whatnick/rpi-camera-led/firmware/README.md

# CH32V003A4M6 camera-LED controller firmware

Firmware for the CH32V003A4M6 (RISC-V, SOP-16) sitting on the Raspberry
Pi camera interposer board in this repository. It:

1. drives or tri-states the two camera-side GPIO pins,
2. reads back the two Pi-side GPIO pins (via the tri-stated passthrough),
3. can put either channel into "copy mode" (the Pi's GPIO passes
   straight through to the camera),
4. continuously samples and averages an ambient-light phototransistor,
5. drives two white illumination LEDs via hardware PWM, and
6. supports a fail-safe firmware upgrade over I2C.

Everything is controlled by a Raspberry Pi over I2C, using a plain
"8-bit register pointer, auto-incrementing" protocol compatible with
`i2c-tools` (`i2cget`/`i2cset`/`i2ctransfer`) and kernel `regmap-i2c`
drivers out of the box.

**Build status: both firmware images build successfully with the
open-source toolchain described below. Hardware status: UNTESTED.
Nobody has flashed this onto a real board or scoped a single pin -- see
"Known risks" and "What is untested" at the end of this document.**

## Hardware

(CH32V003A4M6, SOIC/SOP-16; pin numbers follow the SOP-16 column in the
WCH CH32V003 datasheet.) Unlike the smaller package, these package pins
do not bond multiple GPIO ports together:

| Package pin | Port / function | Net | Notes |
|---|---|-----|---|
| 1 | PC1 / I2C1 SDA | SDA | I2C slave on the shared Pi camera bus. |
| 2 | PC2 / I2C1 SCL | SCL | |
| 3 | PC3 / TIM1 CH3 | LED_PWM | Drives the LED MOSFET gate through its series resistor. |
| 4 | PC4 / ADC A2 | LIGHT_SENSE | Phototransistor input; more light raises the sensed voltage. |
| 5 | PC6 | NC | Unused. |
| 6 | PC7 | NC | Unused. |
| 7 | PD1 / SWIO | SWIO | Programming/debug interface; not used for LED PWM. |
| 8 | PD4 | NC | Unused. |
| 9 | PD5 | PI_IO0 | Samples the Pi-side GPIO0 signal. |
| 10 | PD6 | PI_IO1 | Samples the Pi-side GPIO1 signal. |
| 11 | PD7 / NRST | NC | Left unconnected; may act as reset depending on option bytes. |
| 12 | PA1 | CAM_IO0 | Drives or tri-states camera GPIO 11; R6 (10k) links to PI_IO0. |
| 13 | PA2 | CAM_IO1 | Drives or tri-states camera GPIO 12; R7 (10k) links to PI_IO1. |
| 14 | VSS | GND | |
| 15 | VDD | 3V3 | |
| 16 | PC0 | NC | Unused. |

When the camera-side GPIO output is tri-stated, the Pi-side state passes
through the 10k link and can be sampled by PD5/PD6. When the controller
drives PA1/PA2, the 10k resistor limits contention current. PD1 is
reserved for SWIO; PC3/TIM1 CH3 provides LED PWM, so programming does
not intentionally drive the LED gate.

I2C slave address: **0x42** (`I2C_SLAVE_ADDR` in `common/layout.h`),
chosen to avoid the camera (0x10/0x1A/0x36) and EEPROMs (0x50/0x54)
already on the bus.

## Architecture

16KiB of flash is split into two independently-linked images:

```
0x0000 - 0x0FFF   bootloader   (4KiB)   -- always runs first
0x1000 - 0x3FFF   application  (12KiB)  -- code + a 16-byte trailer
```

2KiB of SRAM is shared: the first 16 bytes are reserved for a
cross-reset handshake word (see "Upgrade protocol" below) that is
**not** zeroed by C runtime startup, so it can carry a value across a
warm reset; the rest is split identically by both linker scripts
(`bootloader/bootloader.ld`, `app/app.ld`) but is otherwise fully
available to whichever image is currently running -- the two images
are never active at the same time, so there's no need to partition RAM
between them beyond that one shared word.

The bootloader **always** runs first (the chip always starts executing
at flash address 0 after reset). On every boot it:

1. Computes the application's CRC32 and compares it to the CRC32
   stored in the application's own trailer.
2. If valid **and** no upgrade was requested, jumps straight to the
   application. This is not free: the CRC32 is bit-banged (see
   `common/crc32.h`, deliberately table-free to save flash) at roughly
   70 CPU cycles per byte, so 12KiB costs on the order of **20ms** at
   48MHz. The device does not acknowledge anything on I2C during that
   window, on every reset and every power-on. That is comfortably
   inside the time a Raspberry Pi takes to get as far as probing the
   camera bus, but it is worth knowing about, and it is the price of
   the guarantee in point 1.
3. Otherwise, stays resident and serves the I2C bootloader protocol
   until a host either fixes the app and asks it to run, or the app
   itself explicitly asks to be interrupted for an upgrade.

The bootloader **never** erases or programs any flash address outside
the 12KiB application region -- see `program_page()` in
`bootloader/bootloader.c`, which bounds-checks every page index
against `APP_NUM_PAGES` before touching the flash controller. There is
no code path, valid or malformed I2C command, that can make it write
to its own 4KiB.

### Why two separately-linked images "just work"

Each image is built by ch32fun's normal startup code (`handle_reset`
in the submodule's `ch32fun.c`), which sets `mtvec` to that image's
*own* `InterruptVector` symbol (`la a3, InterruptVector; ori a3,a3,3;
csrw mtvec,a3`) and jumps into that image's own `main()`. Since the
bootloader and app are linked with different `FLASH` origins
(`bootloader.ld`: `0x00000000`; `app.ld`: `0x00001000`), this happens
automatically -- the bootloader does not need to (and does not)
manually relocate the app's vector table. "Jumping to the app" is
therefore just a plain function-pointer call to `APP_FLASH_BASE`
(`0x00001000`), which lands on the app's own reset vector and the app
takes it from there (`jump_to_app()` in `bootloader.c`).

Flash reads/writes/erases use the *physical* address
(`APP_FLASH_PHYS_BASE = 0x08001000`), matching how
`ch32v003fun/examples/flashtest/flashtest.c` uses the flash controller
-- the CPU's normal code-fetch/read path uses the *aliased* address
(`APP_FLASH_BASE = 0x00001000`, the boot-remapped alias flash sits at
after reset) for execution. Both addresses read the same bytes; only
the *jump* target needs to be the aliased one (to match what `mtvec`/
`la` compute), and only the flash-controller `FLASH->ADDR`/buffer
writes need to be the physical one (as demonstrated by the stock
`flashtest.c` example).

## Register map (application mode)

I2C slave address `0x42`. All registers are 8-bit-addressed with
auto-increment (a write's first byte sets the pointer; further bytes
in the same write auto-increment it; a read serves from the pointer
and also auto-increments) -- see `common/i2c_slave.h` (MIT-licensed,
vendored from the ch32v003fun submodule's `examples/i2c_slave` **with
local bug fixes**, listed in the header comment of that file). This is
the same "dumb register file" shape `i2c-tools` and kernel
`regmap-i2c` drivers expect.

Both a combined write-then-read (repeated START -- what `regmap-i2c`,
`i2cget -c` and the `I2C_RDWR` ioctl issue) and a separate
write-then-STOP-then-read work: the register pointer is remembered
across transactions, and each addressing phase restarts the burst from
it. The pointer is *not* advanced by a completed read, so repeating a
read without rewriting the pointer re-reads the same registers.

Registers marked RO are re-stamped by the firmware from private state.
The underlying slave driver has one read-only flag for the entire
register file, and the file has to be writable for the RW registers,
so a host physically *can* write to an RO offset -- but the firmware
never believes what it finds there and restores it.

| Reg  | Name | R/W | Description |
|---|---|-----|---|
| 0x00 | WHO_AM_I | RO  | `0xC3` in application mode, `0xB1` in bootloader mode -- read this first to know which one you're talking to. |
| 0x01 | FW_VERSION | RO  | Application firmware version (currently 1). |
| 0x02 | CTRL | RW  | bit0/bit1 = copy-mode enable, channel 0/1. |
| 0x03 | GPIO_OUT | RW  | bit0/bit1 = driven output level, channel 0/1 (only takes effect if OE=1 and copy-mode is off for that channel). |
| 0x04 | GPIO_OE | RW  | bit0/bit1 = 1: drive the pin per GPIO_OUT, 0: tri-state (input). Ignored (forced to tri-state) while copy-mode is enabled for that channel. |
| 0x05 | GPIO_IN | RO  | bit0/bit1 = live pin level, channel 0/1. When tri-stated (copy mode, or OE=0) this is the Pi's passed-through state; when driven (OE=1, copy mode off) this reads back the value we're driving. |
| 0x06 | LED | RW  | LED brightness, 0-255, hardware PWM (~1kHz). 0 is fully off (0% duty), 255 is fully on (100%, not 255/256). |
| 0x07 | (reserved) | - | Reads as 0. |
| 0x08-0x09 | LIGHT | RO  | Illumination, little-endian 16-bit, exponentially averaged (8-sample time constant at 100Hz sampling). Raw ADC is 10-bit, so the value ranges 0-1023, not the full 16-bit range. The two bytes are updated with interrupts masked, so a single 2-byte burst read always returns one consistent sample. |
| 0x7F | BOOT | WO  | Write `0xB0` to ask the running app to reset into the bootloader for a firmware upgrade. |

**Copy mode precedence:** if `CTRL` bit *n* is set, channel *n* is
**always** tri-stated regardless of `GPIO_OE` bit *n* -- that tri-state
*is* the passthrough (the Pi's own driver, through the 10k resistor,
is what reaches the camera; the CH32 just gets out of the way and
reports what it reads back on `GPIO_IN`).

## Register map (bootloader mode)

Same I2C address (`0x42`) and same register-pointer/auto-increment
protocol, exposed only while the bootloader is resident. `WHO_AM_I`
reads `0xB1` here (vs `0xC3` in app mode) so a host can always tell
which firmware it's talking to just by reading register 0.

| Reg | Name | R/W | Description |
|---|---|-----|---|
| 0x00 | WHO_AM_I | RO  | `0xB1`. |
| 0x01 | BL_VERSION | RO  | Bootloader version (currently 1). |
| 0x02 | STATUS | RO  | bit0 BUSY, bit1 OK (last op), bit2 ERR (last op), bit3 APP_VALID (result of the most recent CRC32 check). Informational only -- `RUN_APP` re-verifies from flash and does **not** consult this bit. |
| 0x03 | CMD | WO  | Write a command byte: `0x01` PROGRAM_PAGE, `0x02` VERIFY_APP, `0x03` RUN_APP. BUSY is raised in the same interrupt that accepts the write, so a host may poll STATUS immediately afterwards without racing the command's start. |
| 0x04 | PAGE_INDEX | RW  | Page number (0-191) within the 12KiB application region, for the next PROGRAM_PAGE. |
| 0x05-0x06 | PAGE_CSUM | RW  | Little-endian CRC16/CCITT-FALSE of the 64-byte PAGE_BUF, checked by the bootloader before it touches flash. |
| 0x07 | (reserved) | - | Reads as 0. |
| 0x08-0x47 | PAGE_BUF | RW  | 64-byte page data buffer (the CH32V003's flash erase granularity). |
| 0x48-0x4B | APP_CRC32 | RO  | Little-endian, the CRC32 computed by the most recent VERIFY_APP (or the automatic check at bootloader entry). |
| 0x4C-0x4F | APP_SIZE | RO  | Little-endian, `app_header_t.app_used_size` as last read from flash (always 12288 for images built by this repo's tooling). |

### `PROGRAM_PAGE` semantics

Writing `0x01` to `CMD` erases, programs, and read-back-verifies
*exactly one* 64-byte page of the application region at `PAGE_INDEX`,
from `PAGE_BUF`, but **only if** the CRC16 the bootloader computes over
`PAGE_BUF` matches `PAGE_CSUM` -- a mismatch aborts before touching
flash and sets the ERR bit. This work happens in the bootloader's main
loop (not the I2C interrupt handler), so it can take a few
milliseconds (flash page erase is documented elsewhere in the
ch32v003fun project as ~3ms); **a host must poll STATUS until BUSY
clears (or simply wait ~10ms) before sending the next command** --
see `_wait_not_busy()` / `_program_page()` in `host/rpi_camera_led.py`.
`PAGE_INDEX` is always bounds-checked against the 192-page application
region before any flash access, so a confused or malicious host cannot
make the bootloader touch its own 4KiB.

## Upgrade protocol and its fail-safety argument

The application's flash image ends in a 16-byte trailer
(`app_header_t`, `common/app_header.h`) occupying exactly the last 16
bytes of the last (192nd) page of the application region:

```c
typedef struct {
    uint32_t magic;          // must equal 0xCAFEB007
    uint32_t app_used_size;  // bytes covered by crc32 below, from the
                              // start of the app region (always 12288
                              // for images this repo's tooling builds)
    uint32_t app_crc32;      // CRC32 (zlib/CRC-32/ISO-HDLC variant) of
                              // app_used_size bytes, computed with THIS
                              // FIELD treated as zero
    uint32_t reserved;       // must be 0
} app_header_t;
```

Because the trailer sits at a fixed, compile-time-known address
(`APP_HEADER_ADDR = 0x00003FF0`) regardless of how big the actual
compiled code is, the bootloader never needs to trust anything about
the application's own build beyond this one fixed struct.

The full upgrade sequence, driven by `host/rpi_camera_led.py upgrade`:

1. If the device is currently running the app, write `0xB0` to
   `REG_BOOT`. The app stashes a magic value in the shared NOINIT RAM
   word and triggers a full system reset (`PFIC->SCTLR = 1<<31`). The
   bootloader (which always runs first) sees the magic value, clears
   it, and stays resident regardless of whether the current app's CRC32
   is valid.
2. For each of the 192 pages: write `PAGE_INDEX`/`PAGE_CSUM`/`PAGE_BUF`
   in one I2C transaction, then write `CMD = PROGRAM_PAGE` in a second,
   then poll `STATUS` until not-BUSY and check OK.
3. Write `CMD = VERIFY_APP`; poll; check `APP_VALID`.
4. Write `CMD = RUN_APP`; the bootloader jumps to the (now verified)
   app.

**Why a power cut at any point in this sequence is recoverable:**

- *Before any page is written*, the flash is whatever it was before --
  either the previous (working) app, or already-invalid flash from an
  earlier interrupted attempt. Either way, the CRC32 check at the next
  boot reflects reality.
- *During any single page's erase+program*, the flash controller
  (per `ch32v003fun/examples/flashtest`) can leave that specific page
  in an indeterminate state (partially erased, partially programmed)
  if power is cut mid-operation. This is **not** made atomic by this
  firmware -- it can't be, on this hardware, without a second flash
  bank to hold a journal, which a 16KiB part doesn't have. What *is*
  guaranteed is that the CRC32 check covers the **entire** 12KiB
  region, so **any** single corrupted page (this one, or the one
  holding the header trailer itself) makes the whole-image CRC32
  mismatch on the next boot, and the bootloader falls back to staying
  resident rather than running a partially-written image. The
  in-progress page write is bounds-checked to the app region the whole
  time, so even a power cut mid-erase can never touch the bootloader's
  own 4KiB.
- *Between pages*, or *after the last page but before VERIFY_APP/
  RUN_APP*, the trailer's CRC32 still describes whatever combination of
  old and new page contents happens to be in flash at that instant,
  which (overwhelmingly likely) does not match -- same fallback.
- *A power cut during RUN_APP itself* just means the reset happens
  before the jump instead of after; the bootloader re-runs its CRC32
  check from scratch on the next boot regardless.

There is also **no I2C command sequence that can make the bootloader
jump into an unverified image**. `RUN_APP` recomputes the CRC32 from
flash at the moment of the jump and ignores `BREG_STATUS`; the status
register is host-writable (see the note under "Register map
(application mode)"), so gating the jump on its `APP_VALID` bit would
have let a host write `[0x02, 0x08, 0x03]` -- STATUS = APP_VALID
followed by CMD = RUN_APP in one transaction -- and jump into a blank
or half-programmed app region. Likewise `app_used_size` read out of
the flash trailer is required to be exactly `APP_SIZE` before it is
used as a CRC length, because a corrupt smaller value would underflow
the length arithmetic into a multi-gigabyte walk past the end of flash
and hang the bootloader on every boot.

In short: **the fail-safety guarantee rests entirely on the CRC32
check being cheap, unconditional, and run on every single boot (and
again immediately before every jump) before anything else** -- not on
any single I2C transaction being atomic. The
cross-reset NOINIT handshake word (step 1 above) is *not* part of this
guarantee; it only affects whether the bootloader stays resident when
the CRC32 *is* valid (letting an intentional re-upgrade interrupt a
working app). Concretely: SRAM content after a genuine cold power-on
is not architecturally guaranteed to be any particular value, so this
firmware never relies on the handshake word being zero/absent after a
real power loss -- it only ever matters when the CRC32 is already
valid, and reading it as (spuriously) "enter bootloader" in that case
just means an extra unnecessary stay-in-bootloader, never an unsafe
boot into a bad image.

**What this cannot rule out, honestly:** CRC32 is not a cryptographic
checksum. A pathological, exactly-crafted flash corruption pattern
could in principle produce a wrong image whose CRC32 happens to match
its own (also corrupted) stored CRC32 field. Against the kind of
corruption that a power loss during a page erase/program actually
produces (a page left all-0xFF, all-0x00, or a mix of old/new 32-bit
words), this is not a realistic failure mode, but it is not
mathematically impossible, and this document says so plainly rather
than overclaiming.

The I2C-transport-level `PAGE_CSUM` (CRC16) is a **separate**, weaker
check that only protects a single page transfer against I2C bus
corruption *before* it reaches flash -- it plays no role in the
boot-time safety argument above, which is CRC32-only.

## Build

Requires `riscv64-unknown-elf-gcc` (Debian/Ubuntu package
`gcc-riscv64-unknown-elf`) and `uv` (for the trailer-patching Python
step). Both bootloader and app are built with
`-march=rv32ec -mabi=ilp32e`, matching what `ch32v003fun`'s own
`ch32fun.mk` selects for `TARGET_MCU=CH32V003`.

```sh
git submodule update --init firmware/ch32v003fun   # if not already checked out
cd firmware/bootloader && make build
cd ../app && make build
```

Each `Makefile` enforces its flash budget at build time (`checksize`
target) in addition to the linker's own `--print-memory-usage` report,
using `objcopy -O ihex`/`-O binary` for the standard `.elf`/`.bin`/
`.hex` outputs.

The app flash budget is 12272, not 12288 -- the linker script reserves
the last 16 bytes for the trailer that `app/make_trailer.py` patches
in after linking, so the *build itself* fails loudly if application
code would collide with the trailer, rather than silently producing a
corrupt image.

Verified build sizes with GCC 10.2.0:

```
Bootloader: 2304 / 4096 bytes flash, 140 / 2032 bytes RAM
App:        2172 / 12272 bytes flash, 188 / 2032 bytes RAM
```

## Flashing

This firmware has not been flashed to real hardware (see "What is
untested" below). `make flash` in either `bootloader/` or `app/` uses
`minichlink` (built from the `ch32v003fun` submodule, also fully
open-source) over a WCH-LinkE-compatible programmer connected to the
SWIO/PD1 pin.

```sh
cd firmware/bootloader && make flash   # minichlink -w bootloader.bin flash        (0x08000000)
cd firmware/app        && make flash   # minichlink -w app.bin        flash+0x1000 (0x08001000)
```

**Do not use ch32fun.mk's own `cv_flash` target for the application.**
Its `FLASH_COMMAND` writes the image to the bare `flash` address, i.e.
the *start* of flash, which for this image would drop 12KiB of
application (linked to run at 0x1000) on top of the 4KiB bootloader.
`app/Makefile` therefore defines its own `flash` target at
`flash+0x1000`; it also depends on `build` rather than just `app.bin`,
so it cannot flash an image whose `app_header_t` trailer has not been
patched in yet.

The bootloader only needs to be flashed once (via SWD); subsequent
application updates go over I2C via `host/rpi_camera_led.py upgrade`,
which never touches the bootloader's own flash region.

## Host tool

`host/rpi_camera_led.py` (run with `uv run rpi_camera_led.py ...`,
stdlib-only, no packages to install) talks to `/dev/i2c-N` via a small
ctypes wrapper (`host/i2c_raw.py`) around the same `I2C_RDWR` ioctl
`i2c-tools`/`smbus2` use, so it does not depend on `smbus2` at all.

```sh
uv run host/rpi_camera_led.py --bus 1 status
uv run host/rpi_camera_led.py --bus 1 set-led 128
uv run host/rpi_camera_led.py --bus 1 set-oe 0 1
uv run host/rpi_camera_led.py --bus 1 set-gpio 0 1
uv run host/rpi_camera_led.py --bus 1 set-copy 1 1
uv run host/rpi_camera_led.py --bus 1 get-light
uv run host/rpi_camera_led.py --bus 1 upgrade firmware/app/app.bin
```

`upgrade` accepts either a raw linked `app.bin` (it builds and patches
the trailer itself, using `host/app_trailer.py`) or an already-
trailered 12288-byte image (it verifies the trailer before flashing
rather than trusting it blindly).

## Known risks

Things that are *probably* wrong, or that are known to be delicate, but
that cannot be resolved without a board on a bench. Each one says what
to try first if bring-up goes badly, so nobody has to rediscover them.

1. **`I2C1->CTLR2.FREQ` is very likely programmed with the wrong
   value.** `SetupI2CSlave()` computes it as
   `FUNCONF_SYSTEM_CORE_CLOCK / 2000000` = **24**, treating it as a
   divider. The reference manual defines `FREQ[5:0]` as the APB1 clock
   expressed **in MHz**, which here is **48**. FREQ does not set the
   bit rate (that is `CKCFGR`, and only in master mode), but it does
   set the peripheral's internal setup/hold and spike-filter timing, so
   understating it by 2x could violate SDA hold time -- most likely to
   show up at 400kHz, least likely at 100kHz. This has deliberately
   **not** been changed: both places in `ch32v003fun` that touch this
   field (`examples/i2c_slave/i2c_slave.h`, which this file is vendored
   from, and `extralibs/ssd1306_i2c.h`, a widely-used working I2C
   master) use the same expression, so changing it on paper alone
   would be trading a field-proven value for a manual-correct one with
   nothing to test either against. **If the slave misbehaves on a real
   bus, try `FREQ = FUNCONF_SYSTEM_CORE_CLOCK / 1000000` first.**

2. **Clock stretching versus the Raspberry Pi's I2C master.** The
   CH32V003 I2C slave holds SCL low until its event interrupt services
   ADDR/RxNE/TxE. The Pi's `i2c-bcm2835` controller has documented
   trouble with slaves that stretch the clock (the BCM2835 datasheet
   erratum around stretching at the start of a read). Because the
   camera bus is shared with the sensor and the EEPROMs, a badly-timed
   stretch could disturb them too. If this bites, the mitigations are
   to run the bus at 100kHz and to keep the app's interrupt latency
   low; there is no firmware-side way to avoid stretching entirely on
   this peripheral.

3. **The slave stops responding for ~3ms per programmed page.** A
   64-byte erase+program stalls the CPU (that is ch32v003fun's own
   measured figure in `examples/flashtest`), so the I2C event ISR
   cannot run and the master sees the slave stop acknowledging.
   `host/rpi_camera_led.py` waits 10ms after writing `CMD` before it
   starts polling `STATUS`, but whether the Pi's kernel driver reports
   a clean timeout the tool can retry, or something worse, is untested.
   If it turns out to need retries, add them around `_wait_not_busy()`
   in the host tool rather than changing the firmware.

4. **Interrupts are left enabled across flash erase/program.** The I2C
   event ISR executes out of the bootloader's own flash pages while the
   flash controller is busy with a page in the app region.
   ch32v003fun's `flashtest` example already depends on code executing
   from flash during a program (its busy-wait loop is fetched from
   flash), so this is believed safe, but it has not been verified with
   an interrupt firing mid-operation. If page programming proves
   unreliable, wrap `program_page()` in `__disable_irq()` /
   `__enable_irq()` -- at the cost of holding SCL low for the duration.

5. **ADCCLK is 24MHz (HCLK/2).** Copied from ch32v003fun's
   `adc_polled` and `adc_fixed_fs` examples, which both call that the
   right setting for this part -- but ch32fun's own `funAnalogInit()`
   carries an STM32-derived comment saying the ADC clock should not
   exceed 14MHz. The longest sample time (241 cycles, ~10us at 24MHz)
   leaves the 47k phototransistor load plenty of settling time either
   way. If readings look noisy or nonlinear, drop `ADCPRE` to /4 or /8;
   at 100Hz sampling there is no time pressure at all.

6. **Slave-transmitter NAK handling is inherited, not verified.** When
   a master NAKs the last byte of a read, the CH32 I2C leaves a byte
   loaded in `DATAR` and raises AF. The driver clears AF in the error
   handler and relies on the next ADDR event resetting `position` and
   the next TxE overwriting `DATAR`. That is how the upstream example
   behaves; it has not been scoped.

7. **A CRC-valid but functionally broken app is only recoverable over
   SWD.** The bootloader's only test is the CRC32; if an image checksums
   correctly but hangs, or never brings up its I2C slave, or never
   implements `REG_BOOT`, then the bootloader will hand control to it on
   every boot and nothing on the I2C bus can take it back. There is no
   dwell window in which the bootloader listens before jumping (adding
   one would mean answering at 0x42 during the camera bus's own probe
   on every power-up, which is its own hazard). The practical
   consequence: **only ever ship an app image that has been tested via
   `upgrade` on a board you can still reach with a WCH-LinkE**, and keep
   `REG_BOOT` working in every future app revision.

8. **CRC32 is not a cryptographic checksum**, so a pathological flash
   corruption pattern could in principle produce a wrong image whose
   CRC32 matches its own (also corrupted) stored value. See the
   discussion at the end of "Upgrade protocol" -- this is not a
   realistic outcome of a power cut during a page erase/program, but it
   is not mathematically impossible either.

## What is untested

**Nothing in this firmware has been run on real CH32V003A4M6 silicon,
or on any hardware at all.** Specifically untested:

- Whether the pin/peripheral configuration (GPIO alternate functions,
  ADC channel mapping, TIM1 CH3 routing to PC3) actually
  produces the described electrical behaviour on this specific
  package/board.
- Actual I2C bus timing and electrical behaviour of any kind -- see
  "Known risks" items 1-3 above, which cover the peripheral clock
  configuration, clock stretching against the Pi's master, and the
  slave going quiet during flash programming.
- The actual flash page-erase/program timing and read-back-verify
  behaviour on this specific chip revision, and whether relocking
  LOCK|FLOCK between pages (as `flash_lock()` now does) is required,
  merely harmless, or -- least likely -- itself a problem.
- Whether triggering `PFIC->SCTLR = 1<<31` from application code
  (used for the "enter bootloader" request) behaves as expected on
  this chip/silicon revision, and how long the I2C bus is unresponsive
  across that reset.
- The host tool's ioctl-based I2C implementation (`host/i2c_raw.py`)
  against a real Linux `i2c-dev` device node -- it has only been
  exercised against a Python-level mock of the bootloader's register
  state machine (see the git history for `firmware/host/`), which
  validates the *protocol logic* (page sequencing, checksums, mode
  transitions) but says nothing about real I2C electrical/timing
  behaviour.
- Real-world ADC noise/averaging behaviour of the phototransistor
  circuit, and whether the 100Hz/8-sample exponential average (~80ms
  to settle) is a sensible time constant for the actual sensor.
- LED PWM frequency (~1kHz) for visible flicker or EMI concerns.

Anyone bringing this up on real hardware should start with `make flash`
of the bootloader alone, verify `status` reports `mode: bootloader`
(a factory-blank chip has no valid app), then flash a minimal app and
work up from there.
