whatnick/rpi-camera-led/hardware/cad/models/Raspberry Pi Camera v3.step

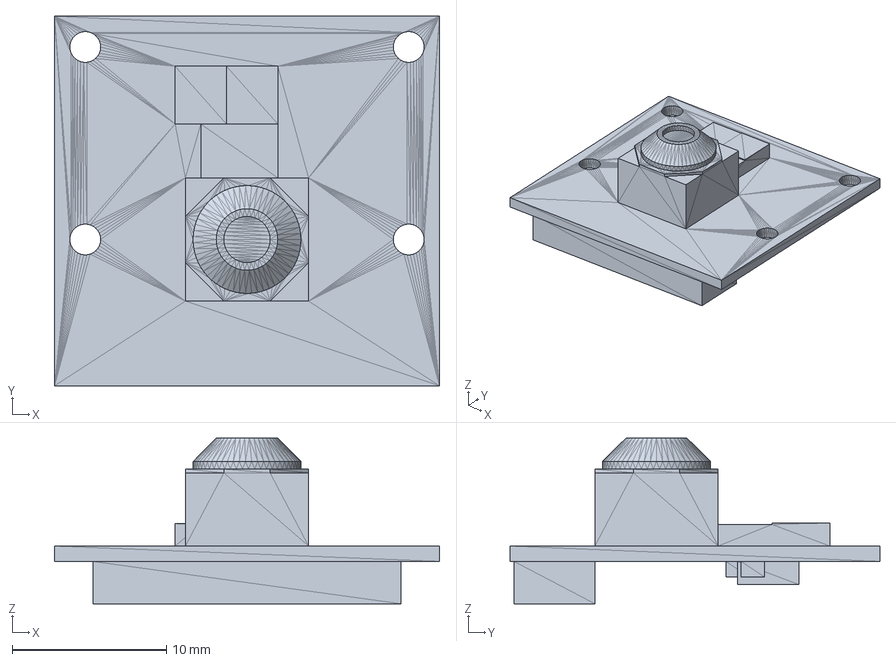
[picture p8: CAD file, 2026-10-16]
hardware/cad/models/Raspberry Pi Camera v3.step
25.0 x 24.0 x 10.8 mm
