whatnick/rpi-camera-led/(list of files, cad)

Other CAD files:
hardware/cad/models/Raspberry Pi Camera v3.3mf
