whatnick/rpi-camera-led/hardware/rpi-camera-led.kicad_pcb

## KiCad design hardware/rpi-camera-led.kicad_pcb (2026-10-16)

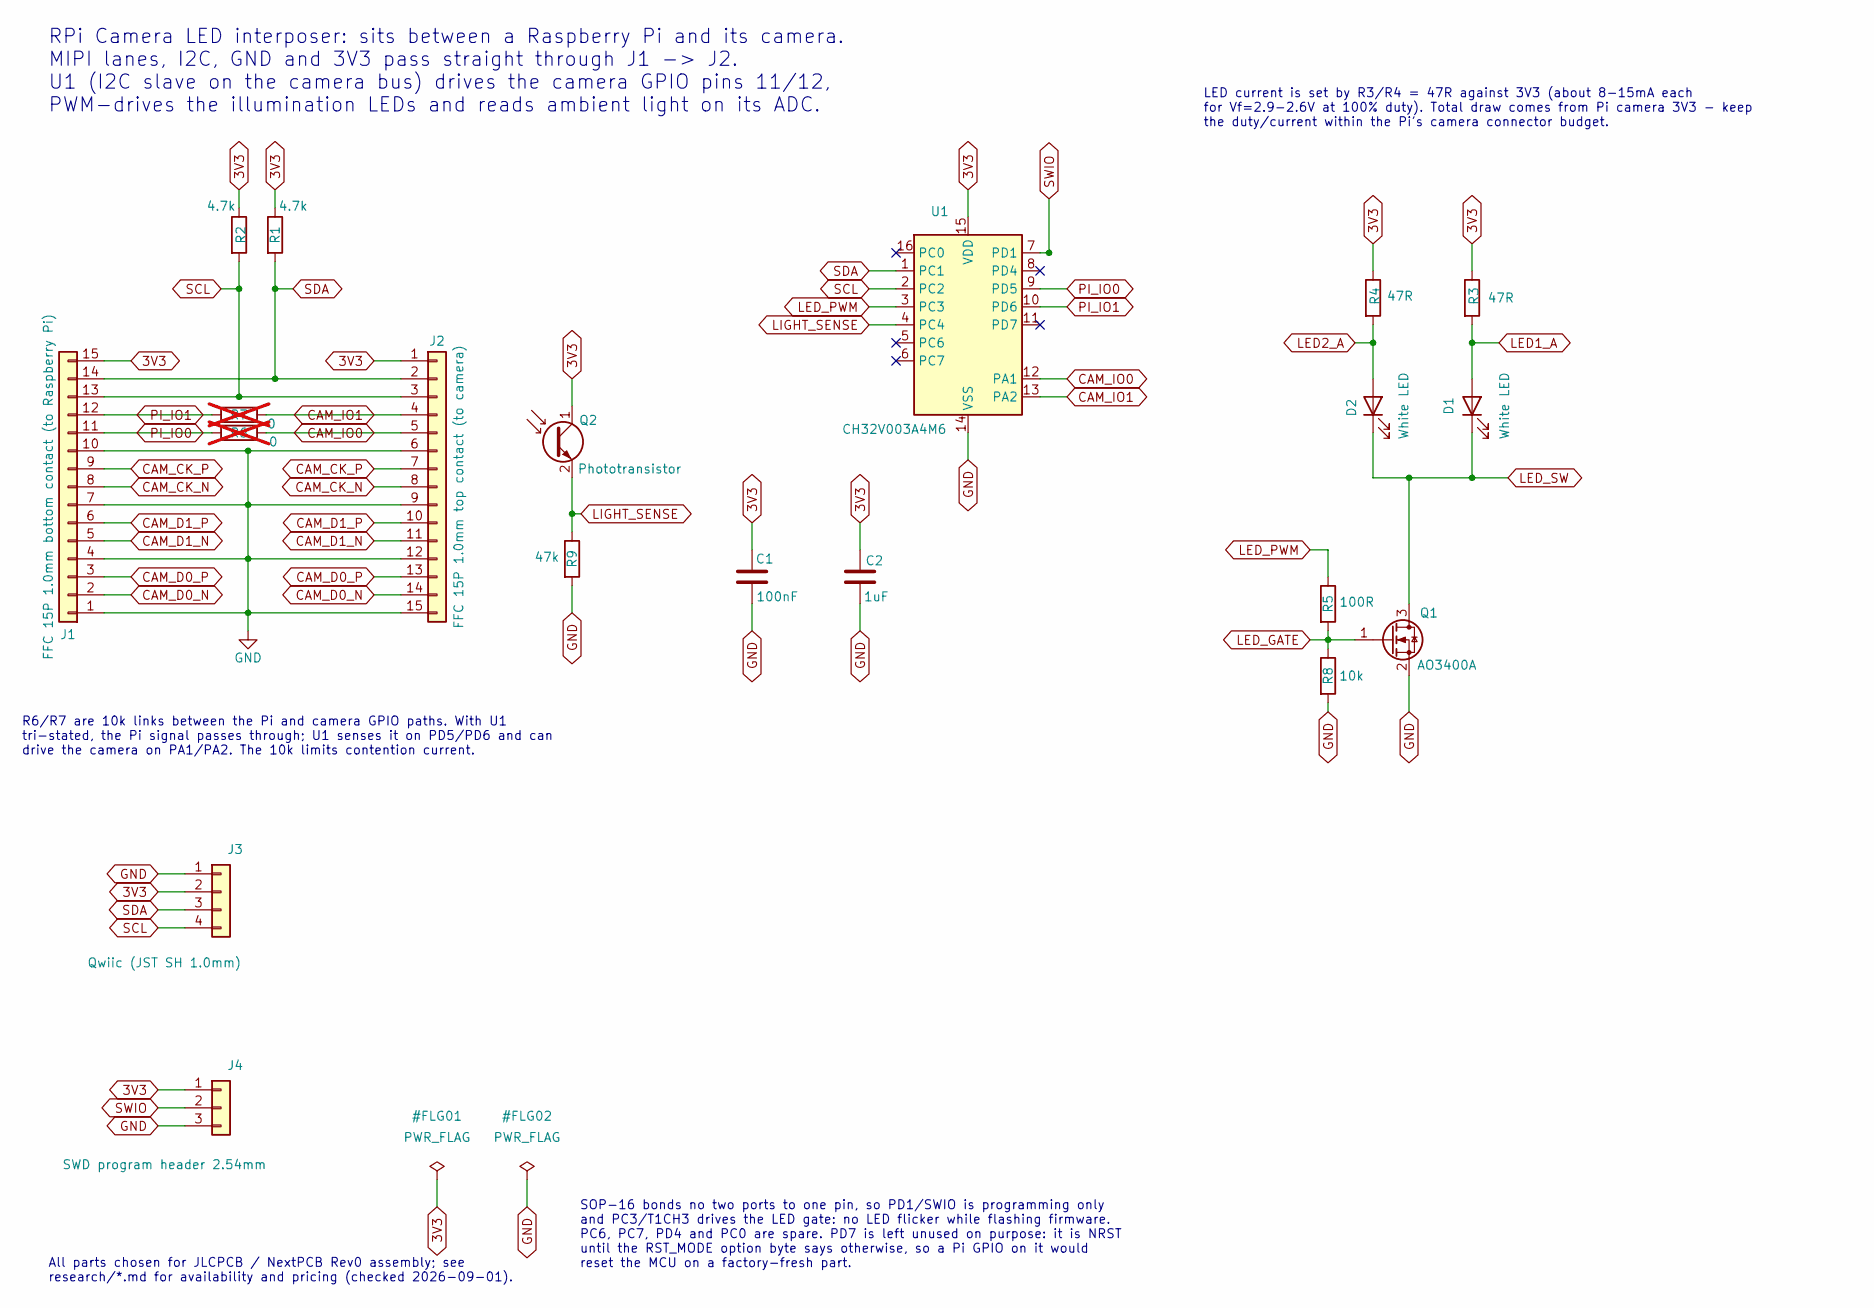
[picture p9: schematic rpi-camera-led.kicad_sch, RPi Camera LED interposer]

Parts:
C1: 100nF; C_0402_1005Metric; MPN GRM155R71A104KA01D; LCSC C71687
C2: 1uF; C_0402_1005Metric; MPN GRM155R61A105KE15D; LCSC C105172
D1, D2: White LED; LED_0805_2012Metric; MPN NCD0805W1; LCSC C110099
J1: FFC 15P 1.0mm bottom contact (to Raspberry Pi); JUSHUO_AFA07-S15FCA-00_1x15-1MP_P1.0mm_Horizontal; MPN AFA07-S15FCA-00; LCSC C262721
J2: FFC 15P 1.0mm top contact (to camera); JUSHUO_AFA07-S15ECA-00_1x15-1MP_P1.0mm_Horizontal; MPN AFA07-S15ECA-00; LCSC C262742
J3: Qwiic (JST SH 1.0mm); JST_SH_SM04B-SRSS-TB_1x04-1MP_P1.00mm_Horizontal; MPN SM04B-SRSS-TB; LCSC C160404
J4: SWD program header 2.54mm; PinHeader_1x03_P2.54mm_Vertical; MPN PBC03SAAN; LCSC C3333754
Q1: AO3400A; SOT-23; MPN AO3400A; LCSC C20917
Q2: Phototransistor; LED_0805_2012Metric; MPN TEMT7000X01; LCSC C499538
R1, R2: 4.7k; R_0402_1005Metric; MPN RC0402FR-074K7L; LCSC C105871
R3, R4: 47R; R_0603_1608Metric; MPN RC0603FR-0747RL; LCSC C114623
R5: 100R; R_0402_1005Metric; MPN RC0402FR-07100RL; LCSC C106232
R6, R7: 0; R_0402_1005Metric; not fitted
R8: 10k; R_0402_1005Metric; MPN RC0402FR-0710KL; LCSC C137965
R9: 47k; R_0402_1005Metric; MPN RC0402FR-0747KL; LCSC C93943
U1: CH32V003A4M6; SOIC-16_3.9x9.9mm_P1.27mm; MPN CH32V003A4M6; LCSC C5346357

Connections:
3V3: C1.1, C2.1, J1.15, J2.1, J3.2, J4.1, Q2.1 (C), R1.1, R2.1, R3.1, R4.1, U1.15 (VDD)
CAM_CK_N: J1.8, J2.8
CAM_CK_P: J1.9, J2.7
CAM_D0_N: J1.2, J2.14
CAM_D0_P: J1.3, J2.13
CAM_D1_N: J1.5, J2.11
CAM_D1_P: J1.6, J2.10
CAM_IO0: J2.5, R6.2, U1.12 (PA1)
CAM_IO1: J2.4, R7.2, U1.13 (PA2)
GND: C1.2, C2.2, J1.1, J1.4, J1.7, J1.10, J2.6, J2.9, J2.12, J2.15, J3.1, J4.3, Q1.2 (S), R8.2, R9.2, U1.14 (VSS)
LED1_A: D1.2 (A), R3.2
LED2_A: D2.2 (A), R4.2
LED_GATE: Q1.1 (G), R5.2, R8.1
LED_PWM: R5.1, U1.3 (PC3)
LED_SW: D1.1 (K), D2.1 (K), Q1.3 (D)
LIGHT_SENSE: Q2.2 (E), R9.1, U1.4 (PC4)
PI_IO0: J1.11, R6.1, U1.9 (PD5)
PI_IO1: J1.12, R7.1, U1.10 (PD6)
SCL: J1.13, J2.3, J3.4, R2.2, U1.2 (PC2)
SDA: J1.14, J2.2, J3.3, R1.2, U1.1 (PC1)
SWIO: J4.2, U1.7 (PD1)

Notes on the sheet:
All parts chosen for JLCPCB / NextPCB Rev0 assembly; see research/*.md for availability and pricing (checked 2026-09-01).
RPi Camera LED interposer: sits between a Raspberry Pi and its camera. MIPI lanes, I2C, GND and 3V3 pass straight through J1 -> J2. U1 (I2C slave on the camera bus) drives the camera GPIO pins 11/12, PWM-drives the illumination LEDs and reads ambient light on its ADC.
R6/R7 are 10k links between the Pi and camera GPIO paths. With U1 tri-stated, the Pi signal passes through; U1 senses it on PD5/PD6 and can drive the camera on PA1/PA2. The 10k limits contention current.
LED current is set by R3/R4 = 47R against 3V3 (about 8-15mA each for Vf=2.9-2.6V at 100% duty). Total draw comes from Pi camera 3V3 - keep the duty/current within the Pi's camera connector budget.
SOP-16 bonds no two ports to one pin, so PD1/SWIO is programming only and PC3/T1CH3 drives the LED gate: no LED flicker while flashing firmware. PC6, PC7, PD4 and PC0 are spare. PD7 is left unused on purpose: it is NRST until the RST_MODE option byte says otherwise, so a Pi GPIO on it would reset t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

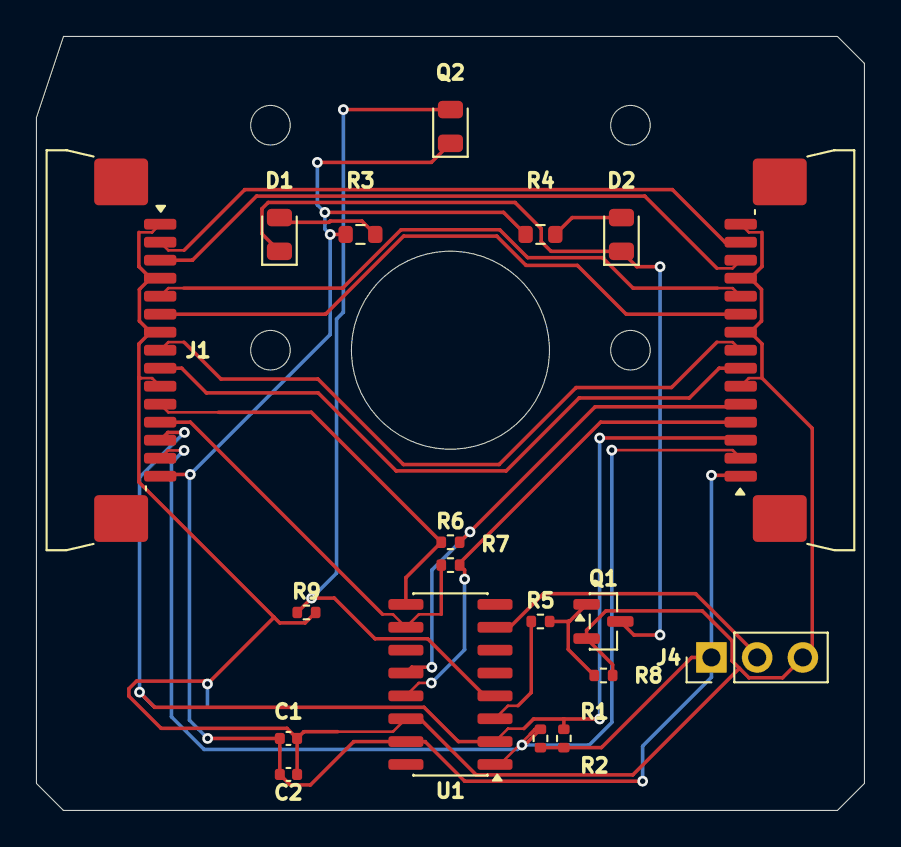
[picture p10: board rpi-camera-led.kicad_pcb from above]

Board: 2 copper layers, 46.0 x 43.0 mm, 24 parts (1 on the bottom side), 21 nets.

Other parts of the board:
H1, H2, H3, H4: MountingHole_2.2mm_M2
