whatnick/rpi-camera-led/(commit log)

2026-10-16 Add manufacturing export script; make kicad-cli lookup cross-platform
2026-10-16 Gate manufacturing exports on board DRC
2026-10-16 Route camera interposer and prepare manufacturing outputs
    Update the CH32V003A4M6 pin mapping, widen and route the board around the camera lens, source the BOM, and add a DRC-gated fabrication export plus approximate assembly CAD renders.
    [rpi-camera-led.kicad_pcb, rpi-camera-led.kicad_sch]
2026-10-16 Refresh manufacturing release status
    Document the current DRC-clean export and remaining production qualifications.
2026-10-16 Move Qwiic connector to board edge
    Reroute J3, enforce its edge placement in PCB checks, and regenerate the manufacturing and assembly outputs.
    [rpi-camera-led.kicad_pcb]
2026-10-16 Refresh camera module 3 fit renders
    Update populated board and assembly renders with a drawing-based Camera Module 3 Standard reconstruction. Document the inferred 6.25 mm optical-axis offset without changing the PCB pending physical verification.
2026-10-16 Add Raspberry Pi camera v3 fit model
    Keep the supplied 3MF in the CAD project, add a repeatable FreeCAD mesh-to-solid STEP conversion, and use the resulting model in the camera assembly renders. Document the observed aperture and mounting-pattern offsets without changing the routed PCB.
    [Raspberry Pi Camera v3.3mf, Raspberry Pi Camera v3.step]
2026-10-16 Redesign interposer for supplied camera v3 model
    Align the aperture and 20 x 12.5 mm mounting pattern to the supplied camera model, move the LED row, and refresh the routed board, manufacturing export, and assembly fit renders.
    [rpi-camera-led.kicad_pcb]
